PLAN-IT-B/BachelorProefCommunicatieEnEinde/README.md

# BachlorProef: Communicatie en einde.
Repository van Henri Vandeputte
