PLAN-IT-B/BachelorProefCommunicatieEnEinde/Algemene documentatie/Bestelling 11 april.docx

Bestelling 11 april - eindpuzzel

Minimum hoeveelheid | Wat | Link
1 | LCD display | (misschien heeft dramco er nog)
1 | 4x3 keypad | https://www.tinytronics.nl/shop/nl/schakelaars/manuele-schakelaars/keypads/keypad-3x4-matrix-membraan
1 | Blauwe (reset) knop | https://www.tinytronics.nl/shop/nl/schakelaars/manuele-schakelaars/drukknoppen-en-schakelaars/grote-blauwe-drukknop-24mm-of-40mm-reset
1 | Groene (start) knop | https://www.tinytronics.nl/shop/nl/schakelaars/manuele-schakelaars/drukknoppen-en-schakelaars/grote-groene-drukknop-24mm-of-40mm-reset
17 | 2 pin terminal block | https://www.tinytronics.nl/shop/nl/kabels-en-connectoren/connectoren/schroefterminals/2-pin-schroef-terminal-block-connector-5.08mm-afstand
3 | 3 pin terminal block | https://www.tinytronics.nl/shop/nl/kabels-en-connectoren/connectoren/schroefterminals/3-pin-schroef-terminal-block-connector-5.08mm-afstand
3 | Relais | https://www.tinytronics.nl/shop/nl/schakelaars/relais/relais-5v-250vac-10a
