PLAN-IT-B/BachelorProefCommunicatieEnEinde/Algemene documentatie/HenriVandeputte-GanttChart.pdf

22 | 27 | 6 | 13 | 20 | 27 | 3 | 10 | 17 | 24 | 1 | 8 | 15
Feb '22 | Mar '22 | Apr '22 | May '22
Planning_BachlorProef | 0h | 7%
Het begin | 0h | 67%
Persoonlijke opdracht gekregen | 0 | 100%
SWOT | 0 | 100%
Gantt chart | 0 | 100%
Implementatie | 0 | 100%
Blokschema persoonlijke opdracht | 0 | 0%
Eindpuzzel vastleggen | 0 | 100%
BOM indienen voor aankoop hardw... | 0 | 0%
Eerste deadline | 0 | 0%
Praktisch ontwerp | 0h | 0%
Datacommunicatie vastleggen | 0 | 0%
Integratie plan maken van alle puz... | 0 | 0%
Integratie van alle puzzels voorbere... | 0 | 0%
Werking puzzel via breadboardimpl... | 0 | 0%
Presentatie maken | 0 | 0%
Tweede deadline | 0 | 0%
PCB design maken | 0 | 0%
PCB ontwerp ter controle voorlegg... | 0 | 0%
PCB ontwerp bestellen | 0 | 0%
Testen van PCB | 0 | 0%
Test your buddy | 0 | 0%
Afgewerkte PCB | 0 | 0%
Technische documentatie op github | 0 | 0%
Deployment van alle puzzels en t... | 0h | 0%
Verslag test your buddy | 0 | 0%
De volledige escape room, klaarma... | 0 | 0%
Testing door eigen studenten | 0 | 0%
Eindverslag | 0 | 0%
Presentatie opdracht | 0 | 0%
Technische documentatie afwerken | 0 | 0%
Presentatie volledige escape room... | 0 | 0%

Het begin

Persoonlijke opdracht gekregen SWOT
Gantt chart
Implementatie
Blokschema persoonlijke opdracht Eindpuzzel vastleggen
BOM indienen voor aankoop hardware Eerste deadline

Praktisch ontwerp

Datacommunicatie vastleggen Integratie plan maken van alle puzzels Integratie van alle puzzels voorbereiden Werking puzzel via breadboardimplementatie Presentatie maken
Tweede deadline
PCB design maken
PCB ontwerp ter controle voorleggen voor finale bestelling PCB ontwerp bestellen
Testen van PCB
Test your buddy
Afgewerkte PCB
Technische documentatie op github

Deployment van alle puzzels en testing

Verslag test your buddy
De volledige escape room, klaarmaken voor gebruik Testing door eigen studenten Eindverslag
Presentatie opdracht
Technische documentatie afwerken
Presentatie volledige escape room + individuele opdracht

Powered by TCPDF (www.tcpdf.org)
