PLAN-IT-B/BachelorProefCommunicatieEnEinde/Algemene documentatie/Blokdiagramen cijfersloten.png

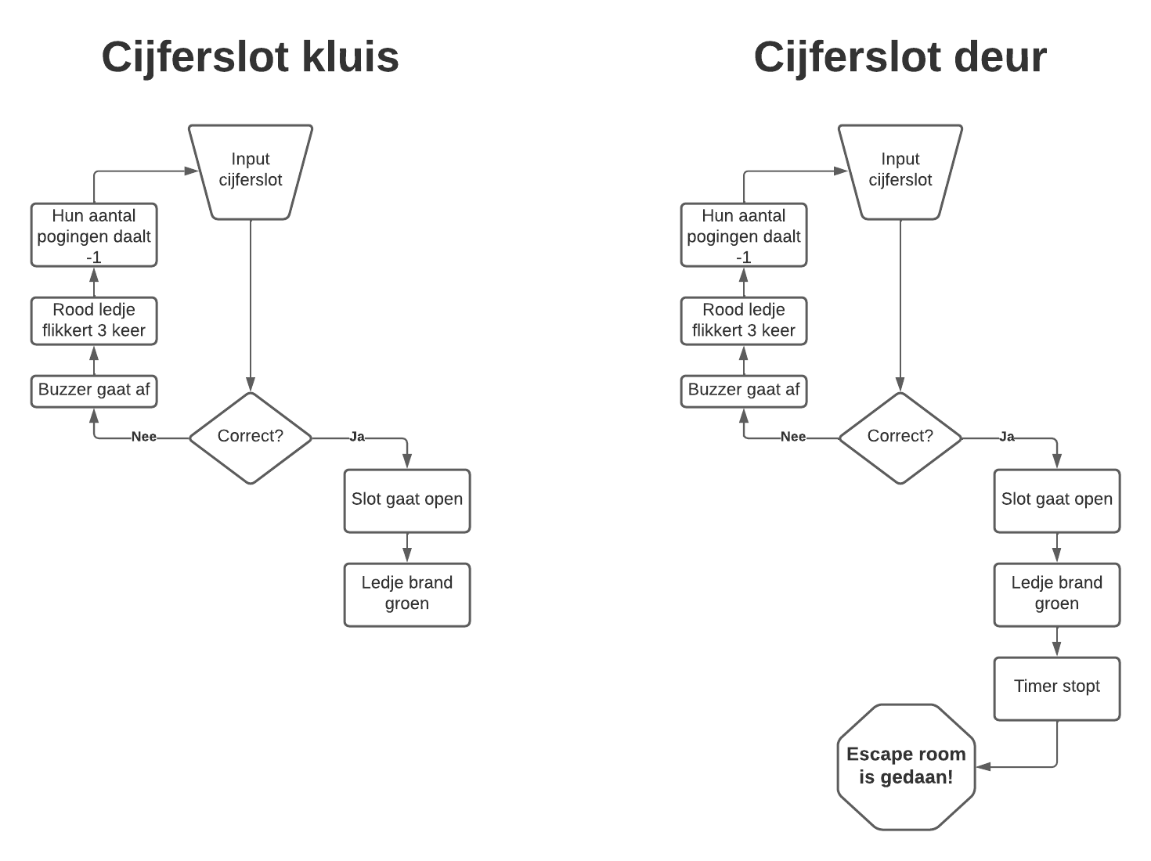
Algemene documentatie/Blokdiagramen cijfersloten.png
