PLAN-IT-B/BachelorProefCommunicatieEnEinde/Algemene documentatie/Flowchart reset-start werking.png

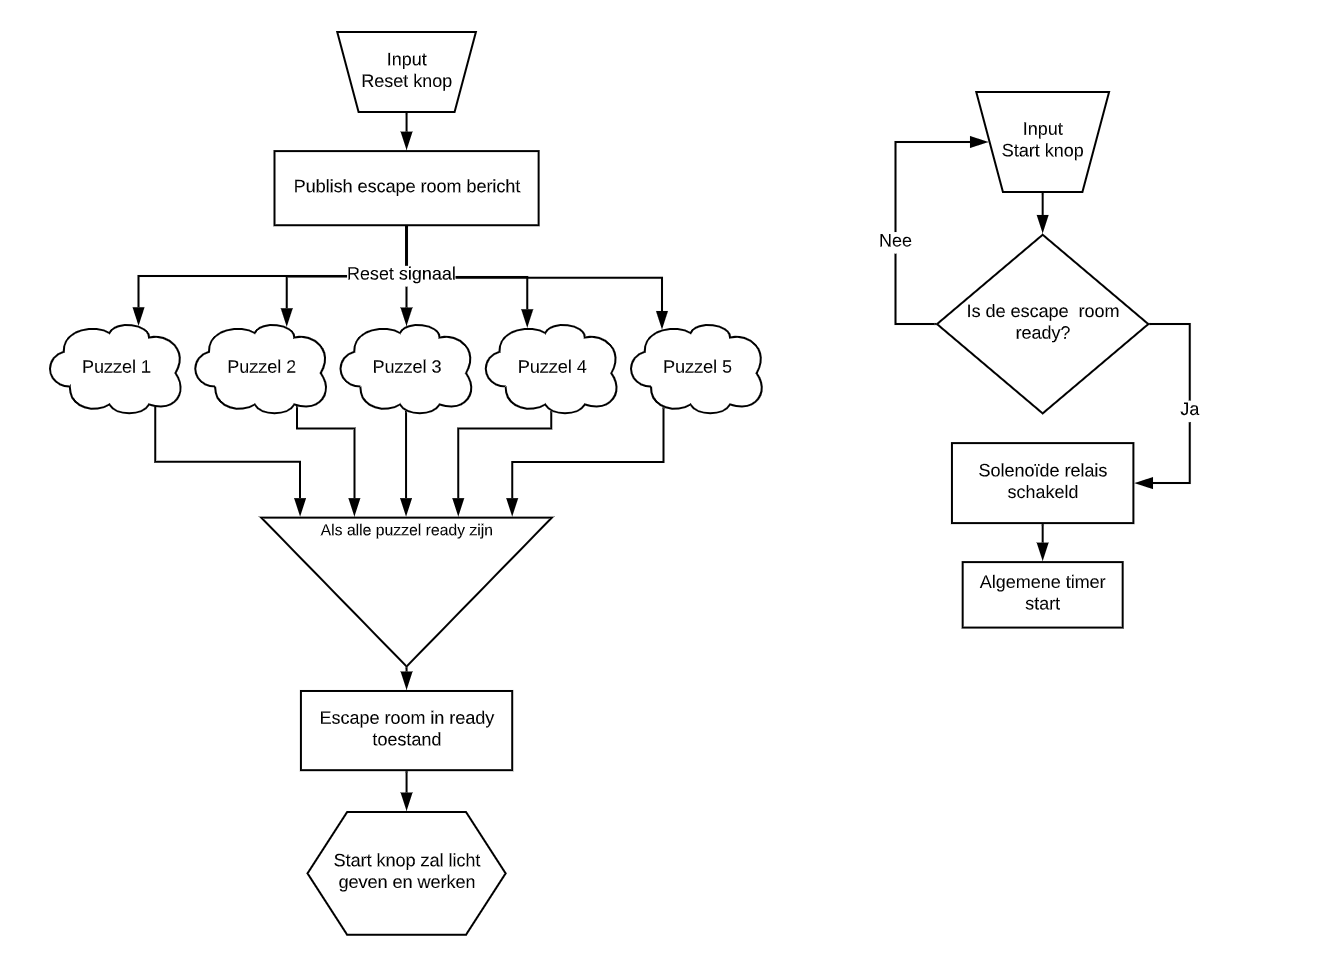
Algemene documentatie/Flowchart reset-start werking.png
