PLAN-IT-B/BachelorProefCommunicatieEnEinde/Documentatie eindpuzzel/Schakeling/pcb1-achterkant.png

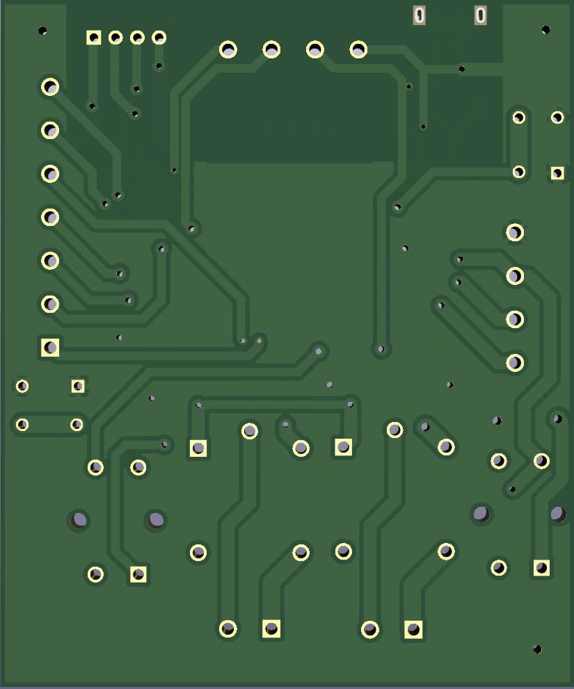
Documentatie eindpuzzel/Schakeling/pcb1-achterkant.png
