PLAN-IT-B/BachelorProefCommunicatieEnEinde/Documentatie eindpuzzel/Schakeling/pcb1-voorkant.png

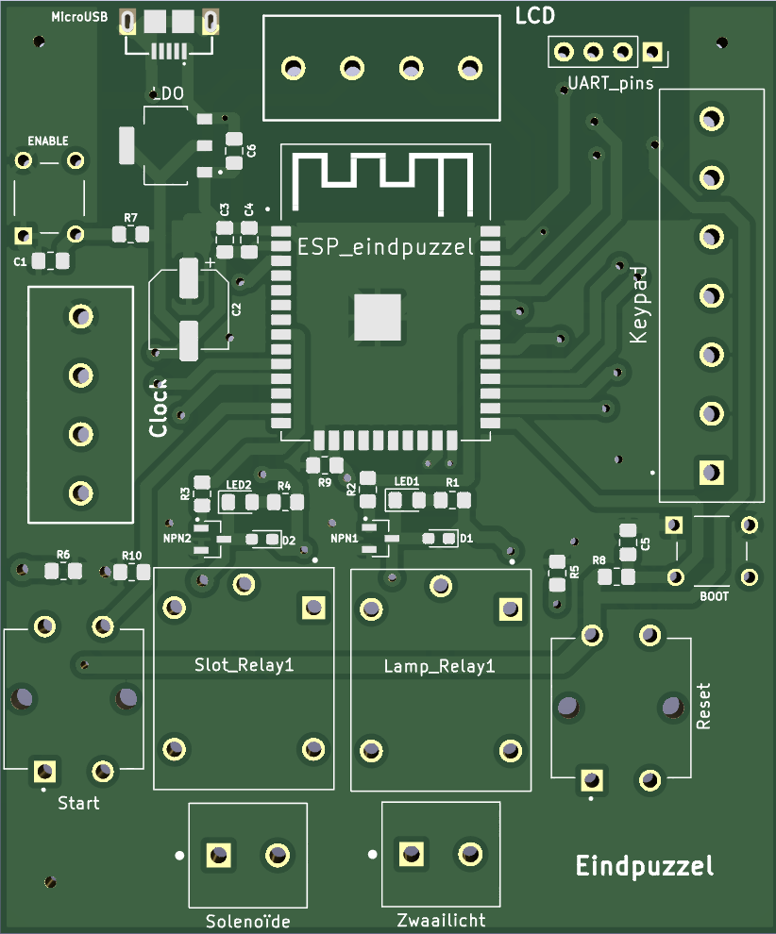
Documentatie eindpuzzel/Schakeling/pcb1-voorkant.png
