PLAN-IT-B/BachelorProefCommunicatieEnEinde/Documentatie UV-slot/Schakeling_UV-Lock/pcb2-achterkant.png

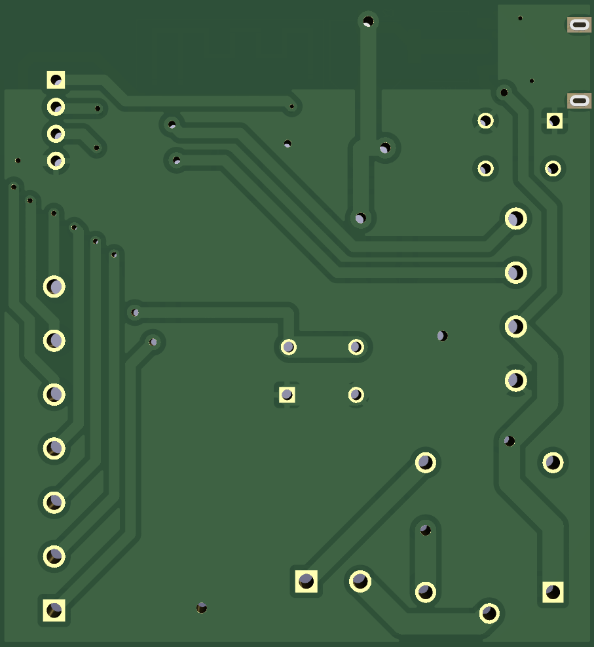
Documentatie UV-slot/Schakeling_UV-Lock/pcb2-achterkant.png
