PLAN-IT-B/BachelorProefCommunicatieEnEinde/Documentatie UV-slot/Schakeling_UV-Lock/pcb2-voorkant.png

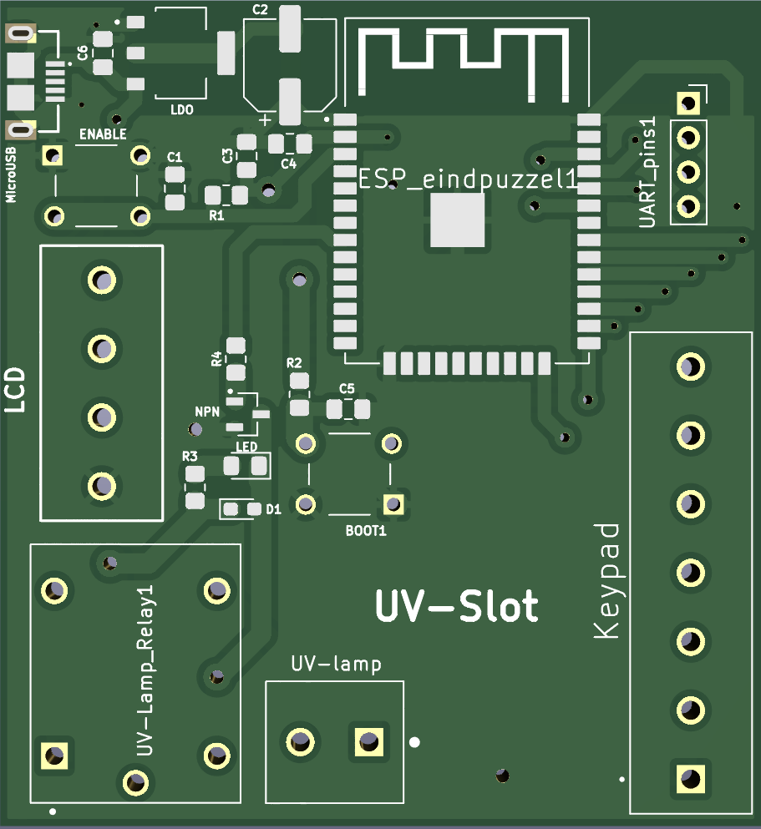
Documentatie UV-slot/Schakeling_UV-Lock/pcb2-voorkant.png
