PLAN-IT-B/BachelorProefCommunicatieEnEinde/Algemene documentatie/BOM Componenten.docx

Componenten lijst

Hoeveelheid | Wat | Waarvoor | Afbeelding | In bezit?

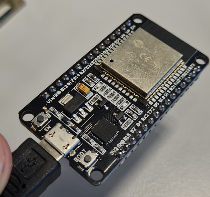
[picture p9: figure]
Geen beschrijving beschikbaar.

2 | Esp32 | 1 voor deurslot 1 voor kluisslot
1 | Raspberry | MQTT broker

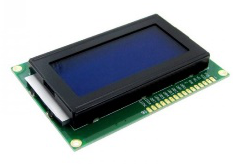
[picture p10: figure]
LCD Display 16*4 Karakters met Witte Tekst en Blauwe Backlight

2 | LCD display https://www.tinytronics.nl/shop/nl/displays/lcd/lcd-display-16*4-karakters-met-witte-tekst-en-blauwe-backlight | Feedback van hun ingetypte code weergeven | | 1 van de 2

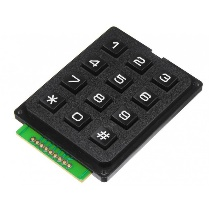
[picture p11: figure]
3x4 matrix keypad zwart

2 | 4x3keypads https://www.tinytronics.nl/shop/nl/schakelaars/manuele-schakelaars/keypads/keypad-3x4-matrix-membraan | Gemakkelijk om code in te typen | | 1 van de 2

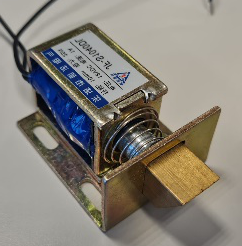
[picture p12: figure]
Geen beschrijving beschikbaar.

2 | Solenoïdes | Het vergrendelen van de kluis/deur

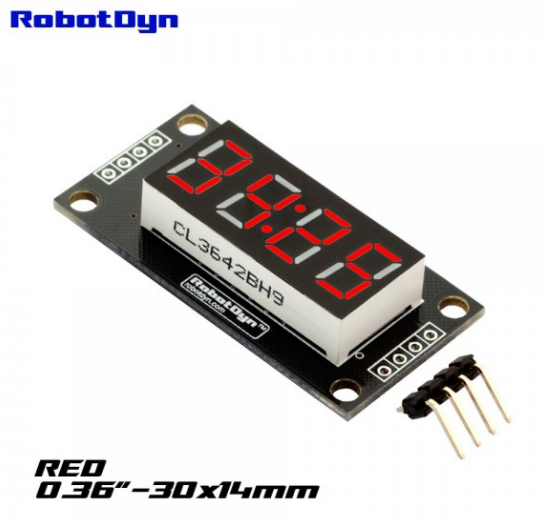
[picture p13: figure]

1 | 7 segment klok display https://www.tinytronics.nl/shop/nl/displays/segmenten/robotdyn-segmenten-display-module-4-karakters-klok-rood-tm1637-mini (Helaas wel zeer klein) | Tijdslimiet van de escape room bijhouden

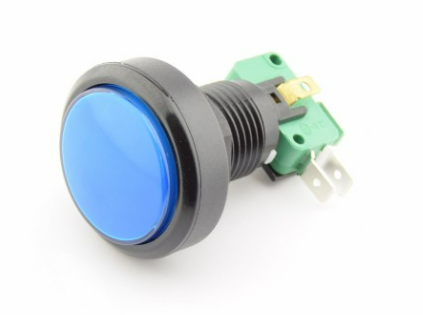
[picture p14: figure]

1 | Reset knop https://www.tinytronics.nl/shop/nl/schakelaars/manuele-schakelaars/drukknoppen-en-schakelaars/grote-blauwe-drukknop-24mm-of-40mm-reset | Zal reset knop zijn van gans de escape room (een reset signaal sturen naar alle puzzels). | | Nee

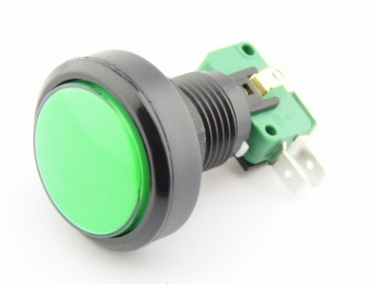
[picture p15: figure]

1 | Start knop https://www.tinytronics.nl/shop/nl/schakelaars/manuele-schakelaars/drukknoppen-en-schakelaars/grote-groene-drukknop-24mm-of-40mm-reset | Zal 30 seconden de solenoide intrekken. (Zodat mensen naar binnen kunnen) Na de 30 seconden zal de deur op slot en de timer starten. | | Nee
