PLAN-IT-B/BachelorProefCommunicatieEnEinde/Documentatie eindpuzzel/PuzzleBox2/Assem2.SLDASM

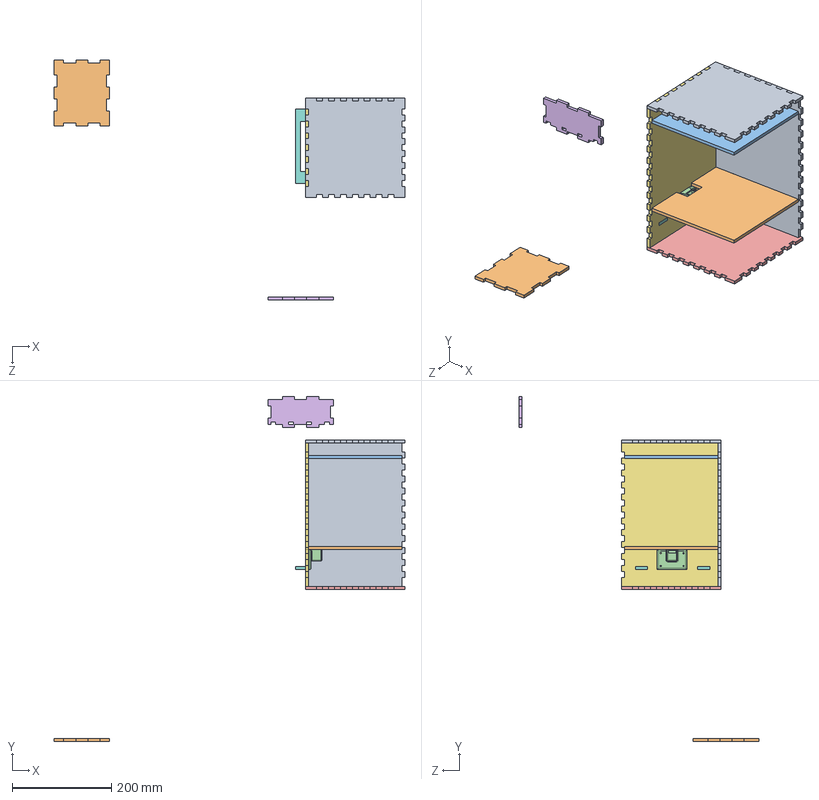
[picture p16: CAD file, 2022-05-20]
Documentatie eindpuzzel/PuzzleBox2/Assem2.SLDASM
706.0 x 694.0 x 482.0 mm
Back
Bottom
Handle
Left
Right
Top
LockFit
Tussenplaat1
Tussenplaat2
Front
