PLAN-IT-B/BachelorProefCommunicatieEnEinde/Documentatie UV-slot/UV-slot Box/Assembly_UV-slot.SLDASM

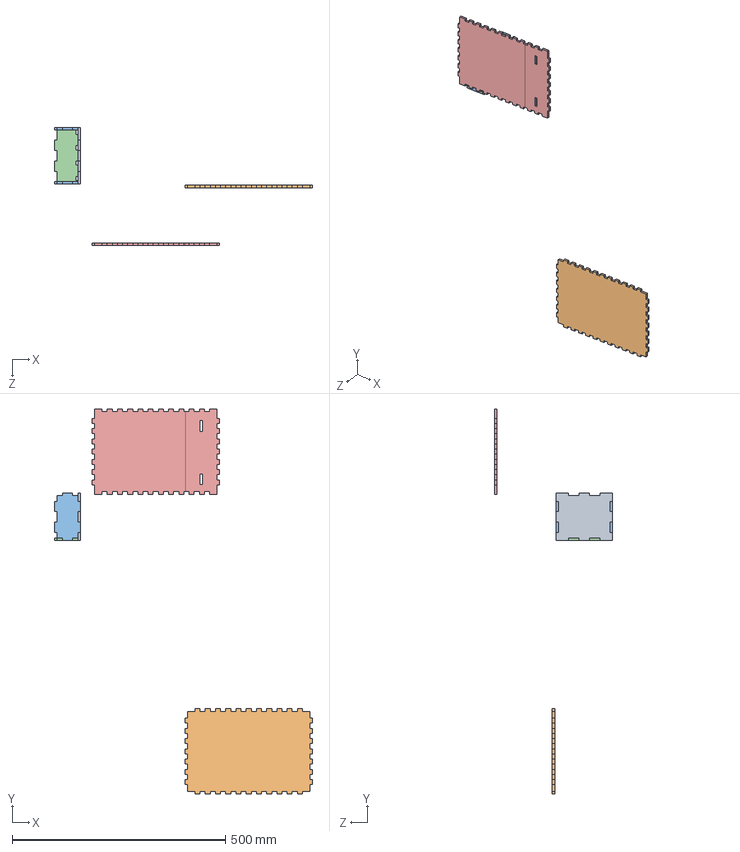
[picture p17: CAD file, 2022-05-20]
Documentatie UV-slot/UV-slot Box/Assembly_UV-slot.SLDASM
606.0 x 903.0 x 276.0 mm
Left
Right
Top&Bottom x 2
Front
Back
