PLAN-IT-B/BachelorProefCommunicatieEnEinde/Documentatie UV-slot/UV-slot Box/STL files/Assembly_UV-slot - Top&Bottom-2.STL

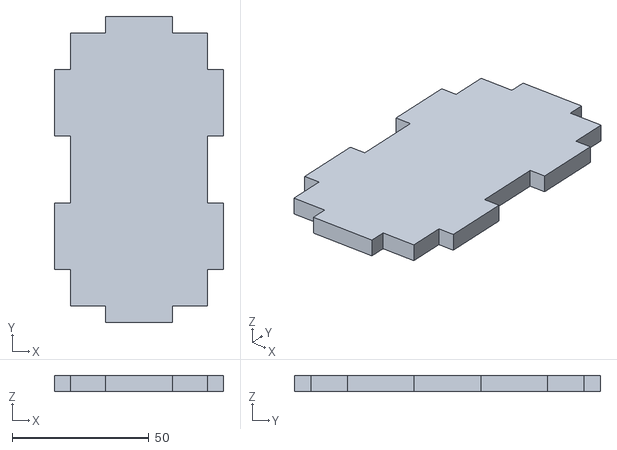
[picture p18: CAD file, 2022-05-22]
Documentatie UV-slot/UV-slot Box/STL files/Assembly_UV-slot - Top&Bottom-2.STL
62.0 x 112.0 x 6.00
