PLAN-IT-B/BachelorProefCommunicatieEnEinde/Documentatie UV-slot/UV-slot Box/STL files/Assembly_UV-slot - Left-1.STL

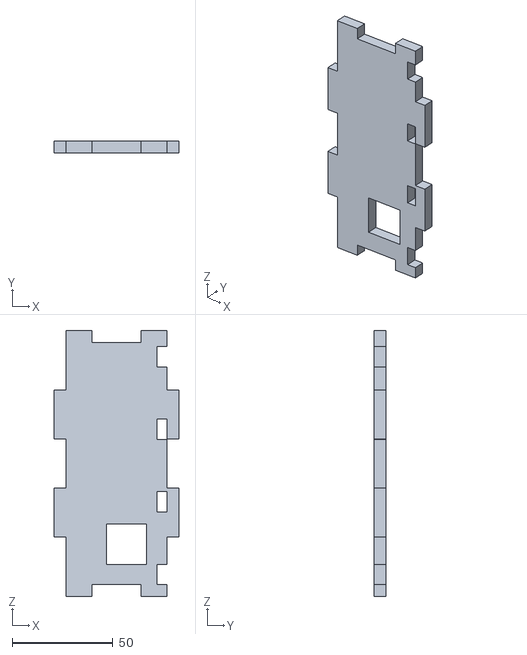
[picture p19: CAD file, 2022-05-22]
Documentatie UV-slot/UV-slot Box/STL files/Assembly_UV-slot - Left-1.STL
62.0 x 6.00 x 132.0
