PLAN-IT-B/BachelorProefCommunicatieEnEinde/Documentatie UV-slot/UV-slot Box/STL files/Assembly_UV-slot - Back-1.STL

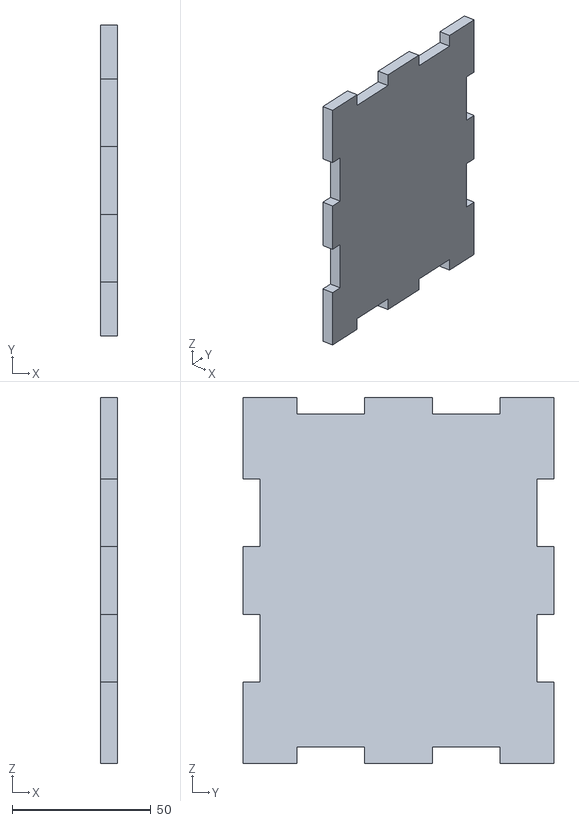
[picture p20: CAD file, 2022-05-22]
Documentatie UV-slot/UV-slot Box/STL files/Assembly_UV-slot - Back-1.STL
6.00 x 112.0 x 132.0
