PLAN-IT-B/BachelorProefCommunicatieEnEinde/Documentatie eindpuzzel/UV-puzzel/Puzzel.SLDPRT

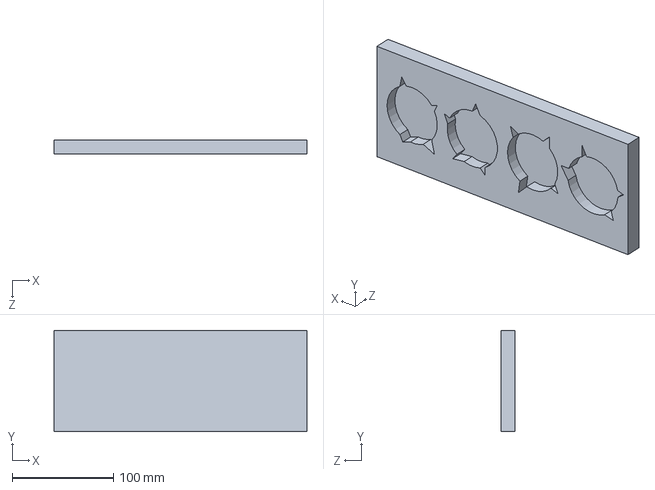
[picture p23: CAD file, 2022-05-21]
Documentatie eindpuzzel/UV-puzzel/Puzzel.SLDPRT
250.0 x 100.0 x 14.0 mm
