PLAN-IT-B/BachelorProefCommunicatieEnEinde/Documentatie eindpuzzel/PuzzleBox2/STL files Puzzlebox/Puzzlebox - Tussenplaat1-1.STL

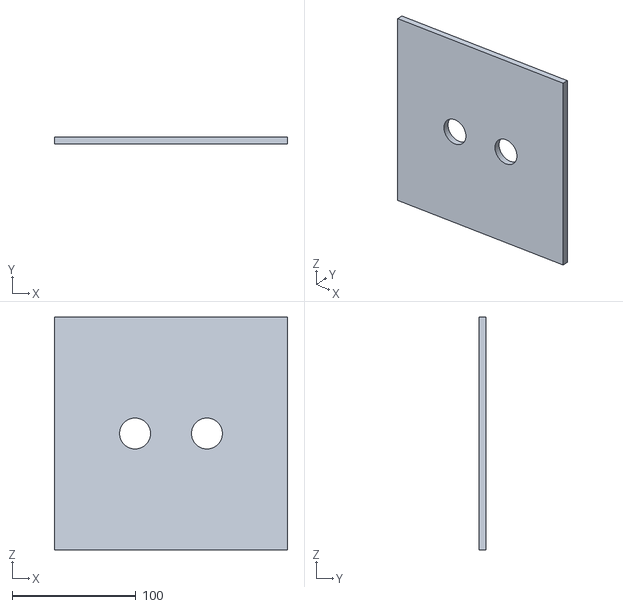
[picture p24: CAD file, 2022-05-22]
Documentatie eindpuzzel/PuzzleBox2/STL files Puzzlebox/Puzzlebox - Tussenplaat1-1.STL
188.0 x 6.00 x 188.0
