PLAN-IT-B/BachelorProefCommunicatieEnEinde/Documentatie eindpuzzel/UV-puzzel/PuzzleCut.DXF

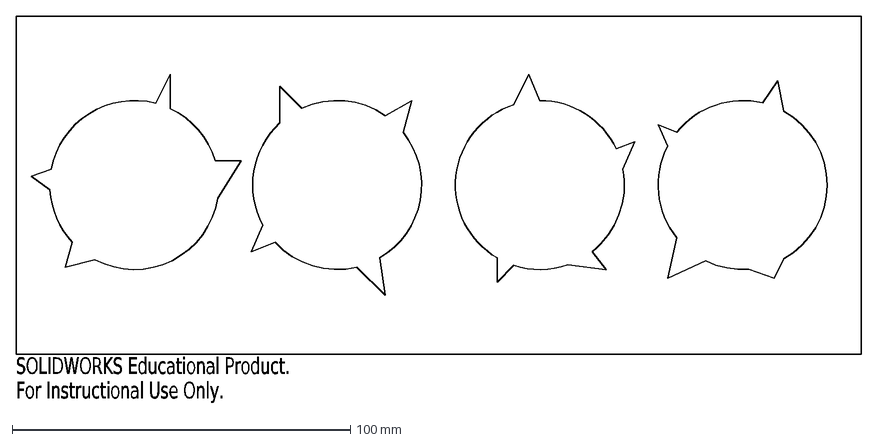
[picture p25: CAD file, 2022-05-17]
Documentatie eindpuzzel/UV-puzzel/PuzzleCut.DXF
SOLIDWORKS Educational Product.
For Instructional Use Only.
