PLAN-IT-B/BachelorProefCommunicatieEnEinde/Documentatie eindpuzzel/PuzzleBox2/STL files Puzzlebox/Puzzlebox - Bottom-1.STL

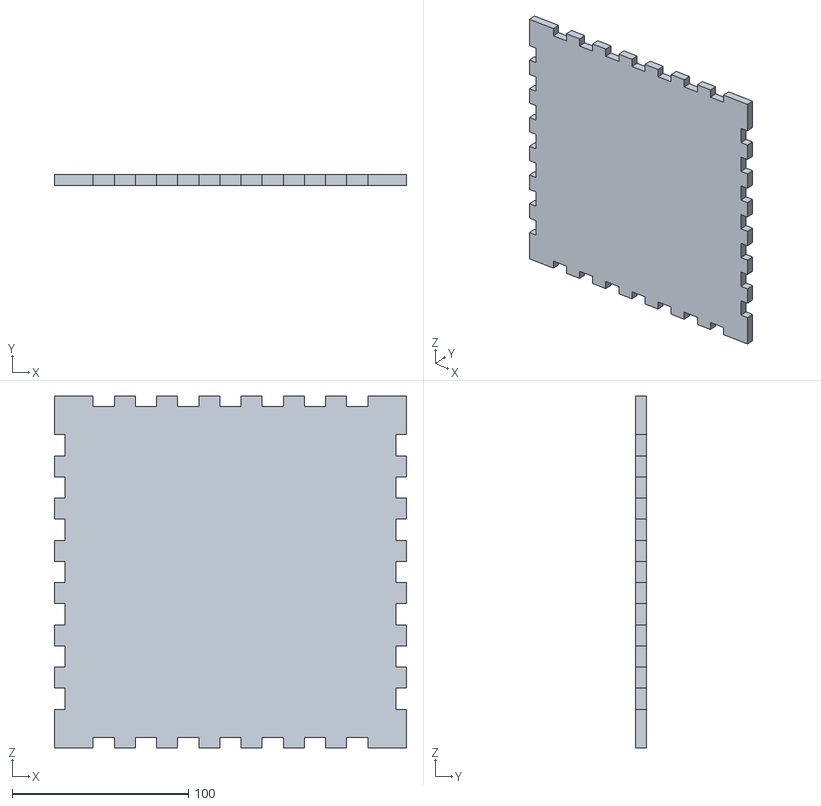
[picture p26: CAD file, 2022-05-22]
Documentatie eindpuzzel/PuzzleBox2/STL files Puzzlebox/Puzzlebox - Bottom-1.STL
200.0 x 6.00 x 200.0
