PLAN-IT-B/BachelorProefCommunicatieEnEinde/Documentatie eindpuzzel/PuzzleBox2/LockFit.SLDPRT

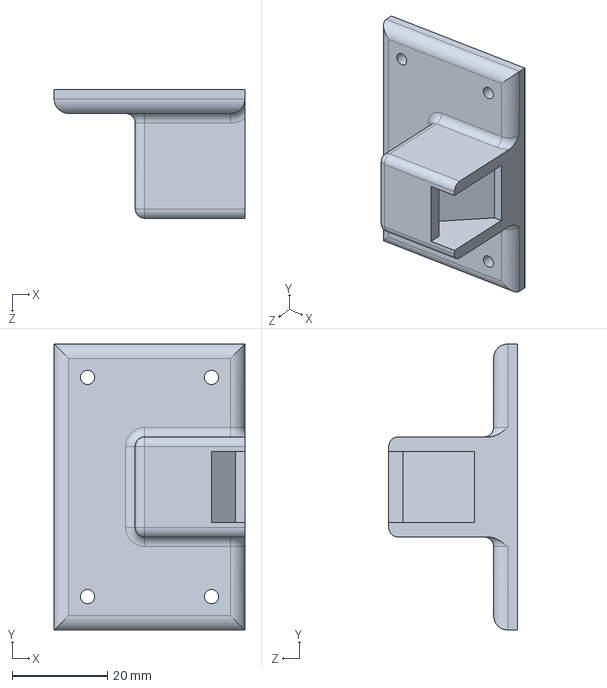
[picture p27: CAD file, 2022-05-14]
Documentatie eindpuzzel/PuzzleBox2/LockFit.SLDPRT
40.0 x 60.0 x 27.0 mm
