PLAN-IT-B/BachelorProefCommunicatieEnEinde/Documentatie eindpuzzel/PuzzleBox2/Tussenplaat2.SLDPRT

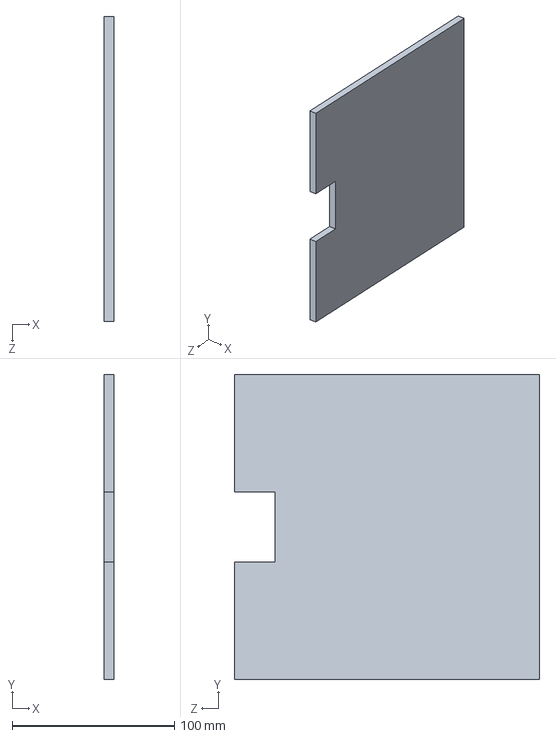
[picture p28: CAD file, 2022-05-09]
Documentatie eindpuzzel/PuzzleBox2/Tussenplaat2.SLDPRT
6.00 x 188.0 x 188.0 mm
