PLAN-IT-B/BachelorProefCommunicatieEnEinde/Documentatie eindpuzzel/PuzzleBox2/STL files Puzzlebox/Puzzlebox - Right-1.STL

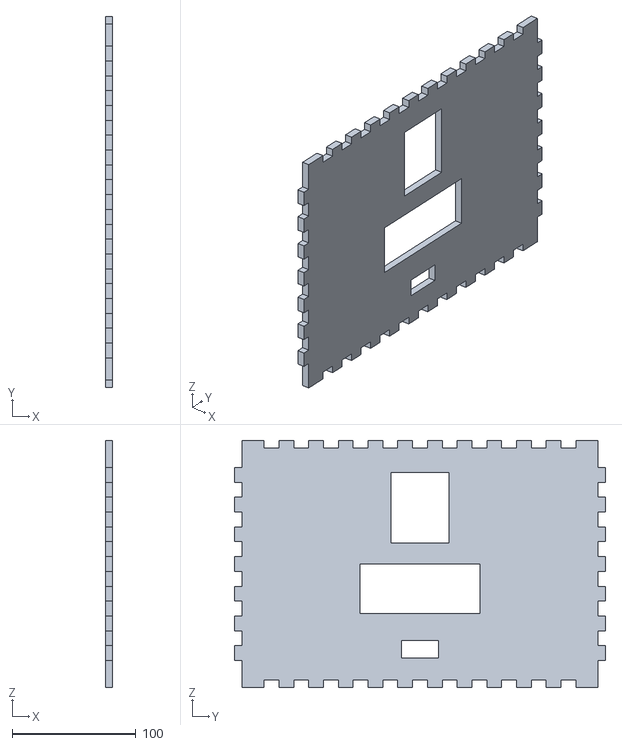
[picture p29: CAD file, 2022-05-22]
Documentatie eindpuzzel/PuzzleBox2/STL files Puzzlebox/Puzzlebox - Right-1.STL
6.00 x 300.0 x 200.0
