PLAN-IT-B/BachelorProefCommunicatieEnEinde/Documentatie eindpuzzel/PuzzleBox2/Handle.SLDPRT

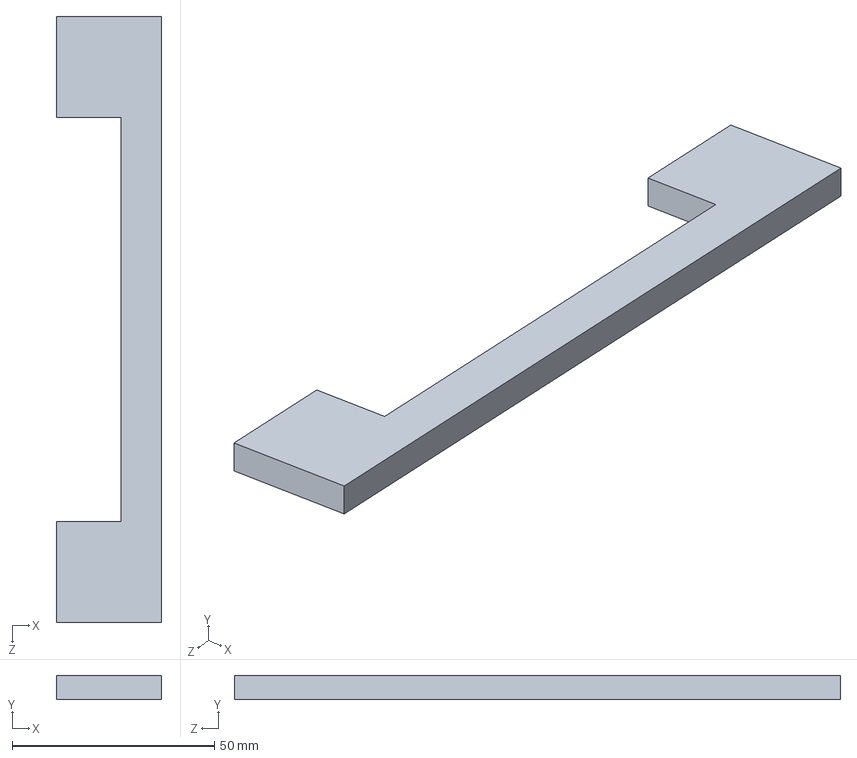
[picture p30: CAD file, 2022-05-06]
Documentatie eindpuzzel/PuzzleBox2/Handle.SLDPRT
26.0 x 6.00 x 150.0 mm
