PLAN-IT-B/BachelorProefCommunicatieEnEinde/Documentatie eindpuzzel/PuzzleBox2/box (3).dxf

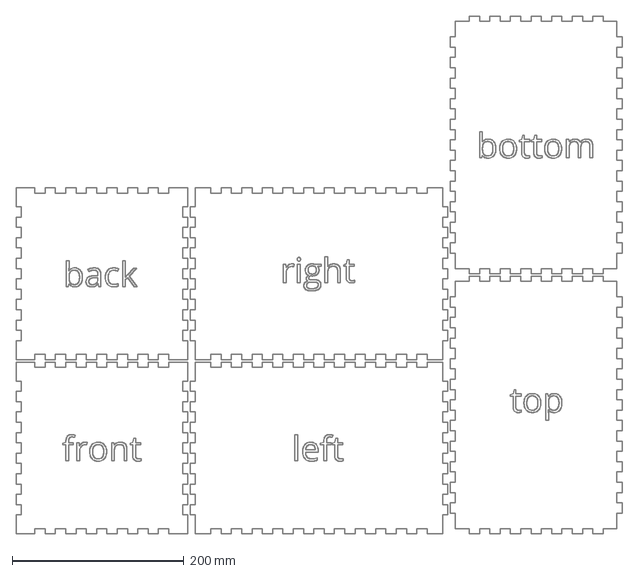
[picture p31: CAD file, 2022-05-06]
Documentatie eindpuzzel/PuzzleBox2/box (3).dxf
706.0 x 603.0 mm
