PLAN-IT-B/BachelorProefCommunicatieEnEinde/Documentatie eindpuzzel/PuzzleBox2/STL files Puzzlebox/LockFit.STL

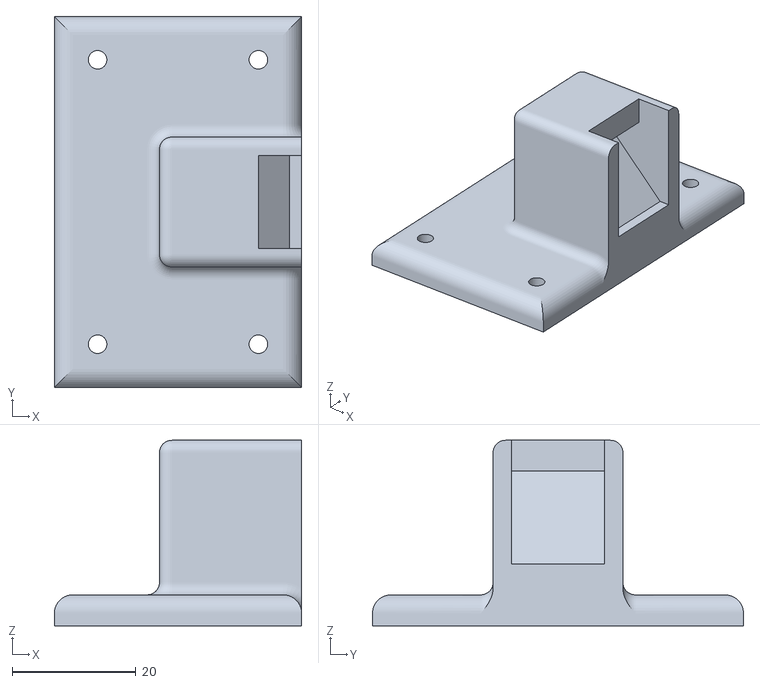
[picture p32: CAD file, 2022-05-14]
Documentatie eindpuzzel/PuzzleBox2/STL files Puzzlebox/LockFit.STL
40.0 x 60.0 x 30.0
