PLAN-IT-B/BachelorProefCommunicatieEnEinde/Documentatie eindpuzzel/PuzzleBox2/Left2.DXF

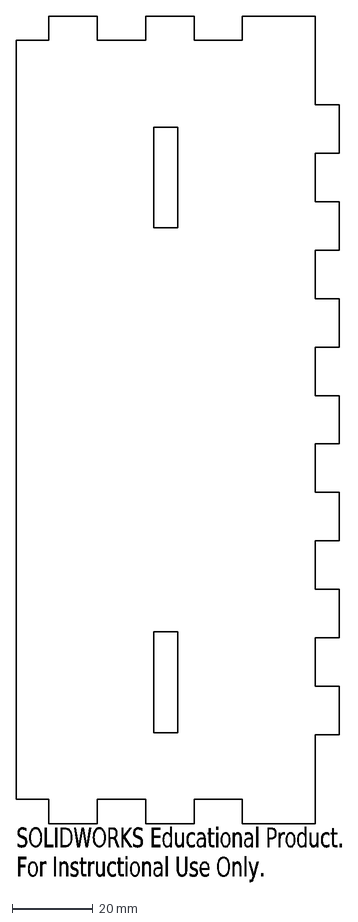
[picture p33: CAD file, 2022-05-06]
Documentatie eindpuzzel/PuzzleBox2/Left2.DXF
SOLIDWORKS Educational Product.
For Instructional Use Only.
