PLAN-IT-B/BachelorProefCommunicatieEnEinde/Documentatie eindpuzzel/PuzzleBox2/Left1.DXF

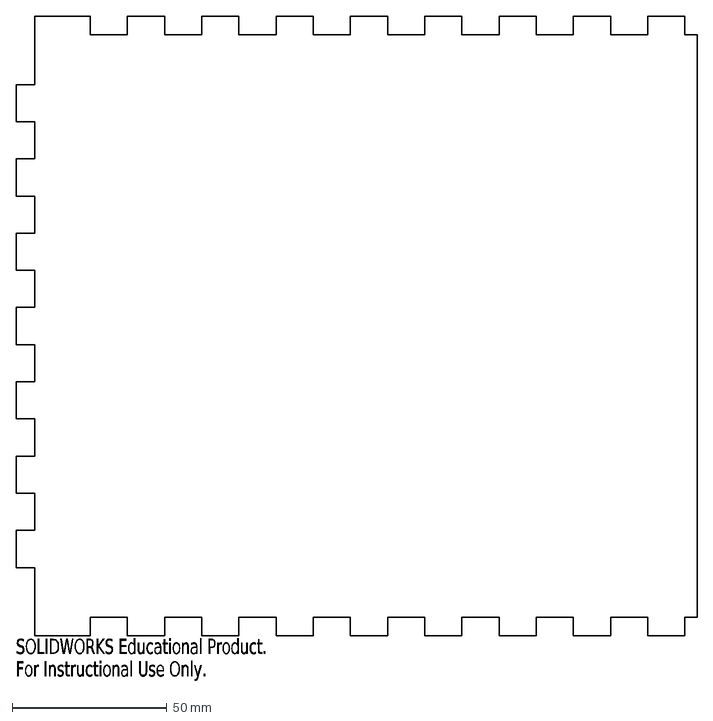
[picture p34: CAD file, 2022-05-06]
Documentatie eindpuzzel/PuzzleBox2/Left1.DXF
SOLIDWORKS Educational Product.
For Instructional Use Only.
