PLAN-IT-B/BachelorProefCommunicatieEnEinde/(list of files, cad)

Other CAD files:
Documentatie UV-slot/UV-slot Box/STL files/Assembly_UV-slot - Top&Bottom-1.STL
Documentatie UV-slot/UV-slot Box/STL files/Assembly_UV-slot - Right-1.STL
Documentatie eindpuzzel/PuzzleBox2/Front.SLDPRT
Documentatie UV-slot/UV-slot Box/Back.SLDPRT
Documentatie eindpuzzel/PuzzleBox2/Left.SLDPRT
Documentatie UV-slot/UV-slot Box/Front.SLDPRT
Documentatie eindpuzzel/PuzzleBox2/STL files Puzzlebox/Puzzlebox - LockFit-1.STL
Documentatie UV-slot/UV-slot Box/Right.SLDPRT
Documentatie eindpuzzel/PuzzleBox2/STL files Puzzlebox/Puzzlebox - Left-1.STL
Documentatie UV-slot/UV-slot Box/Left.SLDPRT
Documentatie eindpuzzel/PuzzleBox2/Tussenplaat1.SLDPRT
Documentatie UV-slot/UV-slot Box/Top&Bottom.SLDPRT
Documentatie eindpuzzel/PuzzleBox2/Back.SLDPRT
Documentatie eindpuzzel/PuzzleBox2/STL files Puzzlebox/Puzzlebox - Back-1.STL
Documentatie eindpuzzel/PuzzleBox2/STL files Puzzlebox/Puzzlebox - Tussenplaat2-1.STL
Documentatie eindpuzzel/PuzzleBox2/Top.SLDPRT
Documentatie eindpuzzel/PuzzleBox2/STL files Puzzlebox/Puzzlebox - Handle-1.STL
Documentatie eindpuzzel/PuzzleBox2/STL files Puzzlebox/Puzzlebox - Top-1.STL
Documentatie eindpuzzel/PuzzleBox2/Bottom.SLDPRT
Documentatie eindpuzzel/PuzzleBox2/Right.SLDPRT
Documentatie UV-slot/UV-slot Box/Back.DXF
Documentatie UV-slot/UV-slot Box/Front.DXF
Documentatie UV-slot/UV-slot Box/Left.DXF
Documentatie UV-slot/UV-slot Box/Right.DXF
Documentatie UV-slot/UV-slot Box/Top&Bottom.DXF
Documentatie eindpuzzel/PuzzleBox2/Back.DXF
Documentatie eindpuzzel/PuzzleBox2/Bottom.DXF
Documentatie eindpuzzel/PuzzleBox2/Front.DXF
Documentatie eindpuzzel/PuzzleBox2/Handle.DXF
Documentatie eindpuzzel/PuzzleBox2/Right.DXF
Documentatie eindpuzzel/PuzzleBox2/Top.DXF
Documentatie eindpuzzel/PuzzleBox2/Tussenplaat1.DXF
Documentatie eindpuzzel/PuzzleBox2/Tussenplaat2.DXF
Documentatie eindpuzzel/UV-puzzel/Puzzel.STL
