PLAN-IT-B/BachelorProefCommunicatieEnEinde/Documentatie eindpuzzel/Te printen documenten/Tip.docx

TIP:

De brochures en posters over de SDG’s zijn niet belangrijk voor het oplossen van de escaperoom.
