PLAN-IT-B/BachelorProefCommunicatieEnEinde/Documentatie eindpuzzel/Te printen documenten/Affiches_SDG.docx

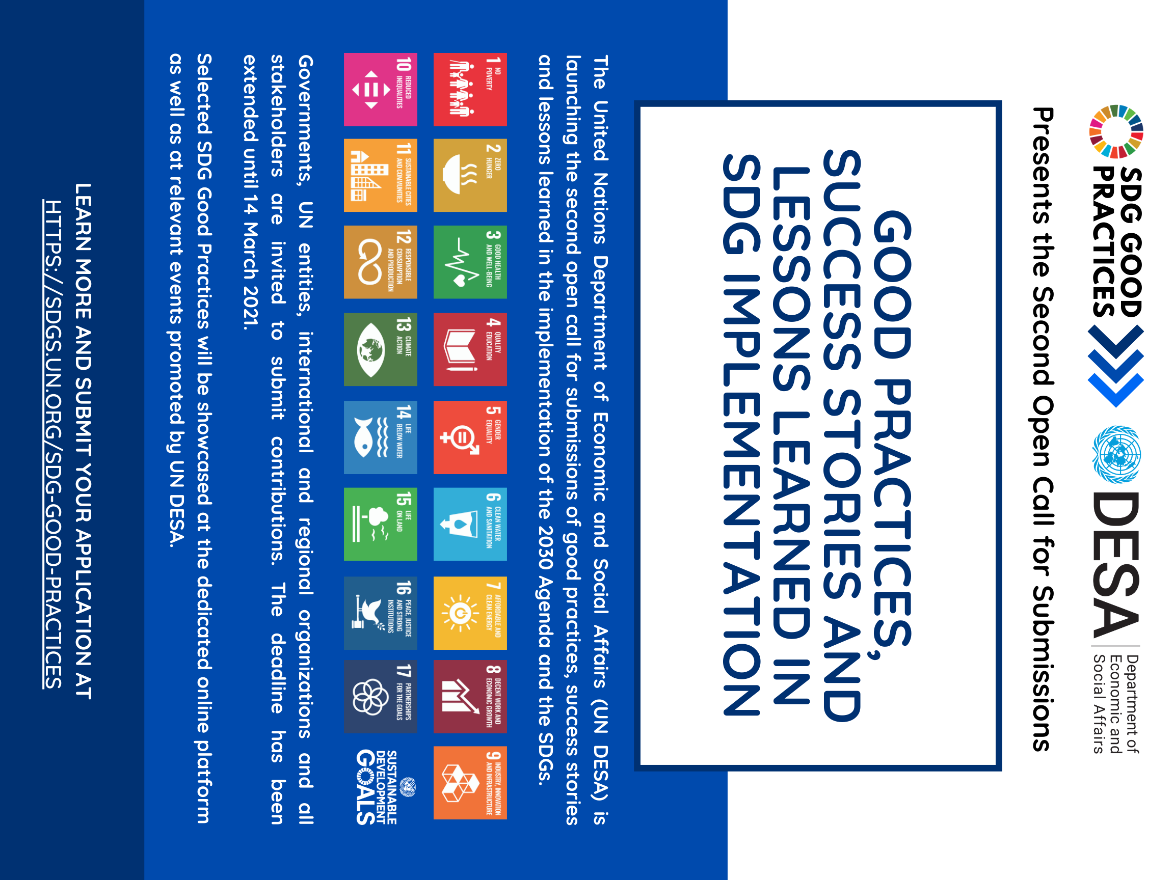
[picture p35: figure]
NOW OPEN! Second Open Call for SDG Good Practices | Global Future Cities Programme
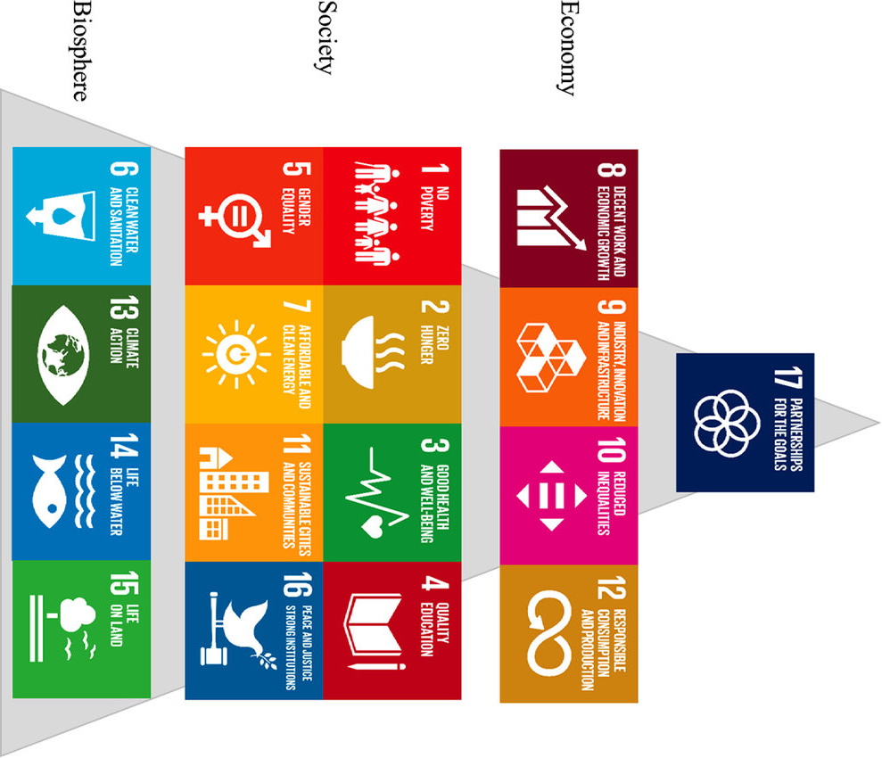
[picture p36: figure]
Interconnections between the SDG, adapted from Rockström and Sukhdev (2016) .
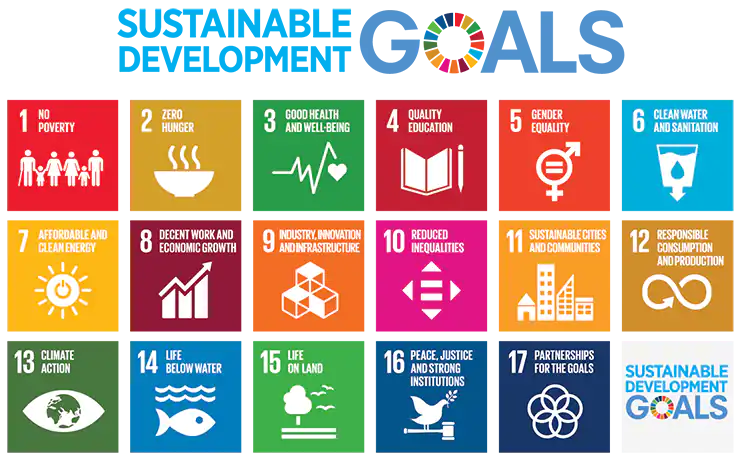
[picture p37: figure]
