PLAN-IT-B/BachelorProefCommunicatieEnEinde/Algemene documentatie/Kosten_Analyse.pdf

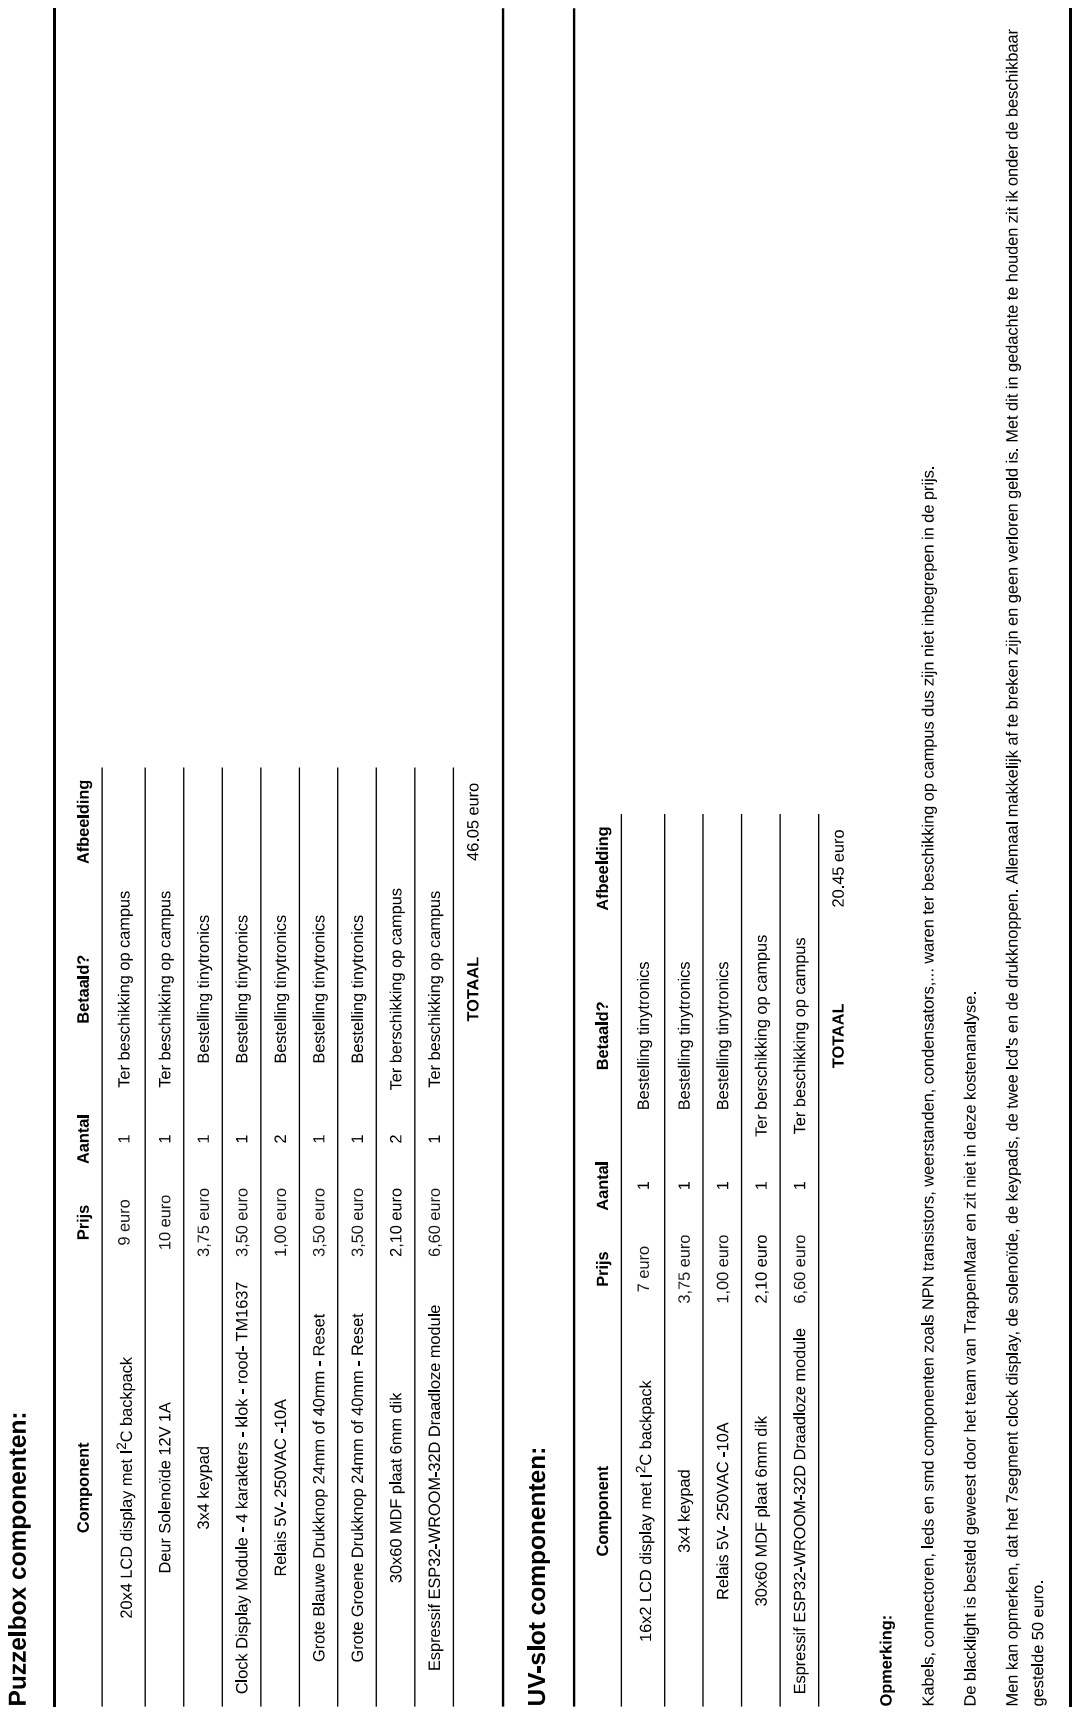
[picture p38: page 1]
