PLAN-IT-B/BachelorProefCommunicatieEnEinde/Documentatie UV-slot/Schakeling_UV-Lock/Schakeling_UV-Lock.kicad_pcb

## KiCad design Documentatie UV-slot/Schakeling_UV-Lock/Schakeling_UV-Lock.kicad_pcb (2022-04-26)

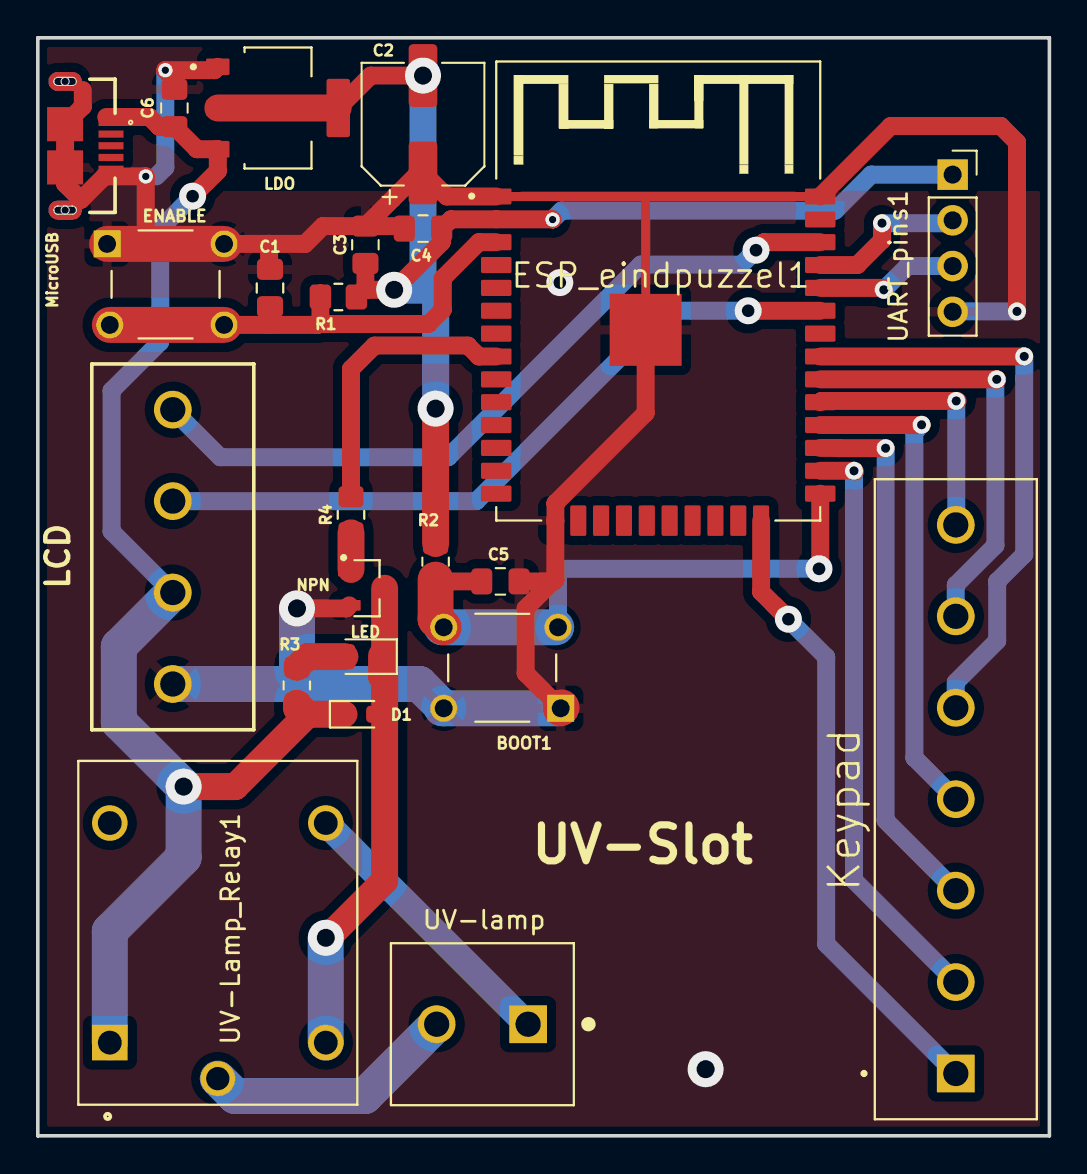
[picture p39: board Schakeling_UV-Lock.kicad_pcb from above]

Board: 2 copper layers, 56.2 x 61.0 mm, 23 parts (0 on the bottom side), 22 nets.

Parts:
BOOT1: SW_Push; TE_3-1825910-1
C1, C4, C5: 0.1u; C_0805_2012Metric_Pad1.18x1.45mm_HandSolder
C2: 220u; CP_Elec_6.3x7.7
C3: 22u; C_0805_2012Metric_Pad1.18x1.45mm_HandSolder
C6: 10u; C_0805_2012Metric_Pad1.18x1.45mm_HandSolder
D1: D; LED_0603_1608Metric_Pad1.05x0.95mm_HandSolder
ENABLE: SW_Push; TE_3-1825910-1
ESP_eindpuzzel1: ESP-WROOM-32; MODULE_ESP-WROOM-32
Keypad: 282841-7; TE_282841-7
LCD: 282841-4; 2828414
LDO: AMS1117; SOT229P700X180-4N
LED: LED; LED_0805_2012Metric_Pad1.15x1.40mm_HandSolder
MicroUSB: USB3090-XX-X_REVE; GCT_USB3090-XX-X_REVE
NPN: BC817; SOT95P230X110-3N
R1, R2: 10k; R_0805_2012Metric_Pad1.20x1.40mm_HandSolder
R3, R4: 1k; R_0805_2012Metric_Pad1.20x1.40mm_HandSolder
UART_pins1: Conn_01x04_Female; PinSocket_1x04_P2.54mm_Vertical
UV-Lamp_Relay1: SRD-05VDC-SL-C; RELAY_SRD-05VDC-SL-C
UV-lamp: 282841-2; TE_282841-2

Connections:
3.3V: C2.2, C3.2, C4.2, ESP_eindpuzzel1.2 (3V3), LDO.2 (VOUT), LDO.4 (VOUT), R1.2, R2.1, UART_pins1.1
5V: C6.1, D1.1 (K), LCD.2, LDO.3 (VIN), MicroUSB.1 (VBUS), R3.1, UV-Lamp_Relay1.A1
GND: BOOT1.1, BOOT1.2, C1.1, C2.1, C3.1, C4.1, C5.1, C6.2, ENABLE.1, ENABLE.2, ESP_eindpuzzel1.1 (GND), ESP_eindpuzzel1.1.1 (GND), ESP_eindpuzzel1.15 (GND), ESP_eindpuzzel1.38 (GND), LCD.1, LDO.1 (ADJ/GND), MicroUSB.5 (GND), MicroUSB.6 (SHIELD), MicroUSB.7 (SHIELD), MicroUSB.8 (SHIELD), MicroUSB.9 (SHIELD), NPN.2, UART_pins1.4
IO2: ESP_eindpuzzel1.24 (IO2), Keypad.1
IO4: ESP_eindpuzzel1.26 (IO4), Keypad.2
IO5: ESP_eindpuzzel1.29 (IO5), Keypad.7
IO16: ESP_eindpuzzel1.27 (IO16), Keypad.3
IO17: ESP_eindpuzzel1.28 (IO17), Keypad.4
IO18: ESP_eindpuzzel1.30 (IO18), Keypad.6
IO19: ESP_eindpuzzel1.31 (IO19), Keypad.5
IO21: ESP_eindpuzzel1.33 (IO21), LCD.3
IO22: ESP_eindpuzzel1.36 (IO22), LCD.4
IO32: ESP_eindpuzzel1.8 (IO32), R4.2
unnamed: C1.2, ENABLE.3, ENABLE.4, ESP_eindpuzzel1.3 (EN), R1.1
unnamed: D1.2 (A), LED.1 (K), NPN.3, UV-Lamp_Relay1.A2
unnamed: BOOT1.3, BOOT1.4, C5.2, ESP_eindpuzzel1.25 (IO0), R2.2
unnamed: NPN.1, R4.1
unnamed: LED.2 (A), R3.2
unnamed: UV-Lamp_Relay1.COM, UV-lamp.2
unnamed: UV-Lamp_Relay1.NO, UV-lamp.1
RX: ESP_eindpuzzel1.34 (RXD0), UART_pins1.3
TX: ESP_eindpuzzel1.35 (TXD0), UART_pins1.2
