PLAN-IT-B/BachelorProefCommunicatieEnEinde/Documentatie eindpuzzel/Schakeling/Schakeling.kicad_pcb

## KiCad design Documentatie eindpuzzel/Schakeling/Schakeling.kicad_pcb (2022-04-16)

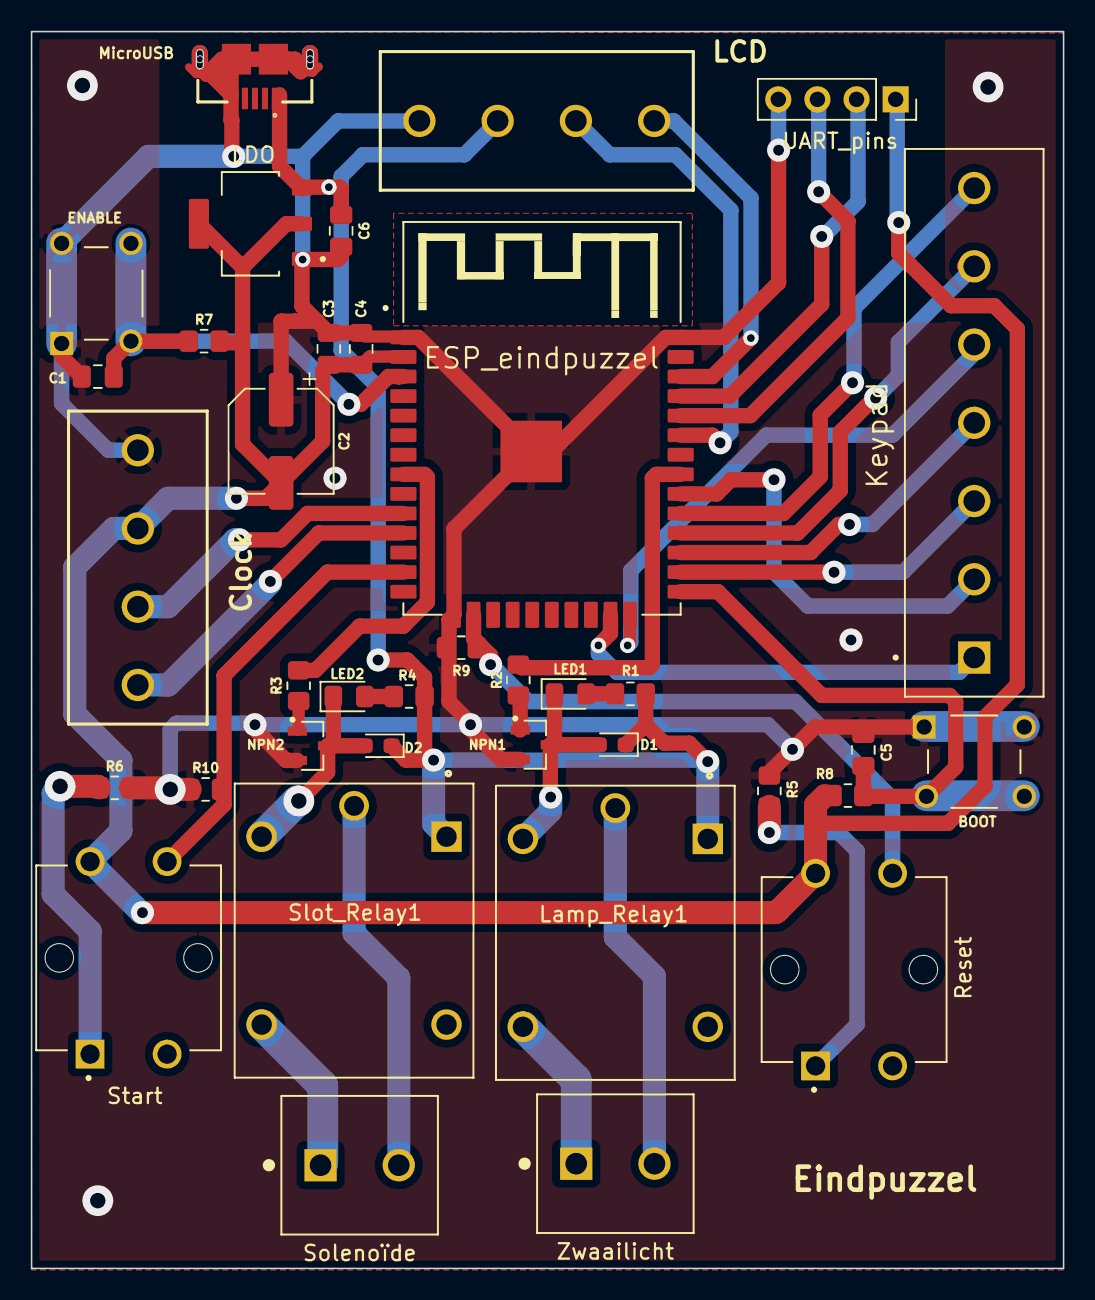
[picture p40: board Schakeling.kicad_pcb from above]

Board: 2 copper layers, 67.0 x 80.3 mm, 37 parts (0 on the bottom side), 34 nets.

Parts:
BOOT: SW_Push; TE_3-1825910-1
C1, C4, C5: 0.1u; C_0805_2012Metric_Pad1.18x1.45mm_HandSolder
C2: 220u; CP_Elec_6.3x7.7
C3: 22u; C_0805_2012Metric_Pad1.18x1.45mm_HandSolder
C6: 10u; C_0805_2012Metric_Pad1.18x1.45mm_HandSolder
Clock: 282841-4; 2828414
D1, D2: D; LED_0603_1608Metric_Pad1.05x0.95mm_HandSolder
ENABLE: SW_Push; TE_3-1825910-1
ESP_eindpuzzel: ESP-WROOM-32; MODULE_ESP-WROOM-32
Keypad: 282841-7; TE_282841-7
LCD: 282841-4; 2828414
LDO: AMS1117; SOT229P700X180-4N
LED1, LED2: LED; LED_0805_2012Metric_Pad1.15x1.40mm_HandSolder
Lamp_Relay1: SRD-05VDC-SL-C; RELAY_SRD-05VDC-SL-C
MicroUSB: USB3090-XX-X_REVE; GCT_USB3090-XX-X_REVE
NPN1, NPN2: BC817; SOT95P230X110-3N
R1, R2, R3, R4, R5, R6, R9, R10: 1k; R_0805_2012Metric_Pad1.20x1.40mm_HandSolder
R7, R8: 10k; R_0805_2012Metric_Pad1.20x1.40mm_HandSolder
Reset: B3F-4050; SW_B3F-4050
Slot_Relay1: SRD-05VDC-SL-C; RELAY_SRD-05VDC-SL-C
Solenoïde: 282841-2; TE_282841-2
Start: B3F-4050; SW_B3F-4050
UART_pins: Conn_01x04_Female; PinSocket_1x04_P2.54mm_Vertical
Zwaailicht: 282841-2; TE_282841-2

Connections:
3.3V: C2.2, C3.2, C4.2, Clock.3, ESP_eindpuzzel.2 (3V3), LDO.2 (VOUT), LDO.4 (VOUT), R7.2, R8.1, Reset.2, Start.2, UART_pins.1
5V: C6.1, D1.1 (K), D2.1 (K), LCD.2, LDO.3 (VIN), Lamp_Relay1.A1, MicroUSB.1 (VBUS), R1.1, R4.1, Slot_Relay1.A1
GND: BOOT.1, BOOT.2, C1.1, C2.1, C3.1, C4.1, C5.1, C6.2, Clock.4, ENABLE.1, ENABLE.2, ESP_eindpuzzel.1 (GND), ESP_eindpuzzel.1.1 (GND), ESP_eindpuzzel.15 (GND), ESP_eindpuzzel.38 (GND), LCD.1, LDO.1 (ADJ/GND), MicroUSB.5 (GND), MicroUSB.6 (SHIELD), MicroUSB.7 (SHIELD), MicroUSB.8 (SHIELD), MicroUSB.9 (SHIELD), NPN1.2, NPN2.2, R5.1, R6.1, R9.1, R10.1, UART_pins.4
IO2: ESP_eindpuzzel.24 (IO2), Keypad.5
IO4: ESP_eindpuzzel.26 (IO4), Keypad.3
IO5: ESP_eindpuzzel.29 (IO5), Keypad.7
IO13: ESP_eindpuzzel.16 (IO13), R9.2, Reset.4 (A)
IO14: ESP_eindpuzzel.13 (IO14), R10.2, Start.4 (A)
IO15: ESP_eindpuzzel.23 (IO15), Keypad.1
IO16: ESP_eindpuzzel.27 (IO16), Keypad.4
IO17: ESP_eindpuzzel.28 (IO17), Keypad.6
IO18: ESP_eindpuzzel.30 (IO18), Keypad.2
IO19: ESP_eindpuzzel.31 (IO19), R2.2
IO21: ESP_eindpuzzel.33 (IO21), LCD.3
IO22: ESP_eindpuzzel.36 (IO22), LCD.4
IO25: Clock.2, ESP_eindpuzzel.10 (IO25)
IO26: Clock.1, ESP_eindpuzzel.11 (IO26)
IO32: ESP_eindpuzzel.8 (IO32), R3.2
unnamed: C1.2, ENABLE.3, ENABLE.4, ESP_eindpuzzel.3 (EN), R7.1
unnamed: D1.2 (A), LED1.1 (K), Lamp_Relay1.A2, NPN1.3
unnamed: D2.2 (A), LED2.1 (K), NPN2.3, Slot_Relay1.A2
unnamed: BOOT.3, BOOT.4, C5.2, ESP_eindpuzzel.25 (IO0), R8.2
unnamed: LED1.2 (A), R1.2
unnamed: LED2.2 (A), R4.2
unnamed: Lamp_Relay1.COM, Zwaailicht.2
unnamed: Lamp_Relay1.NO, Zwaailicht.1
unnamed: NPN1.1, R2.1
unnamed: NPN2.1, R3.1
unnamed: R5.2, Reset.1
unnamed: R6.2, Start.1
unnamed: Slot_Relay1.COM, Solenoïde.2
unnamed: Slot_Relay1.NO, Solenoïde.1
RX: ESP_eindpuzzel.34 (RXD0), UART_pins.3
TX: ESP_eindpuzzel.35 (TXD0), UART_pins.2
