PLAN-IT-B/BachelorProefCommunicatieEnEinde/(commit log)

2022-03-08 Veel updates, adds en removes
    [Logboek.xlsx]
2022-03-15 Ganze dag werk
    [Logboek.xlsx]
2022-03-22 Veel betere code! + timer
2022-03-22 Kuisen van de repository, updaten van logboek en componenten lijst
    [Logboek.xlsx]
2022-03-29 Kicad en code updates
    [Schakeling.kicad_pcb, Schakeling.kicad_sch]
2022-04-07 PCB design files en veel meer
    [Schakeling.kicad_pcb, Schakeling_UV-Lock.kicad_pcb, Schakeling_UV-Lock.kicad_sch]
2022-04-07 Updates pcb eindpuzzel
    [Schakeling.kicad_pcb]
2022-04-13 Veel nieuwe aanpassing in de Kicad files ( en ook een paar in de code)
    [Schakeling.kicad_pcb, Schakeling.kicad_sch, Schakeling_UV-Lock.kicad_pcb, Schakeling_UV-Lock.kicad_sch]
2022-04-13 Wifi antennes extra ruimte gegeven
    [Schakeling.kicad_pcb, Schakeling_UV-Lock.kicad_pcb]
2022-04-16 Finale design PCB's
    [Schakeling.kicad_pcb, Schakeling.kicad_sch, Schakeling_UV-Lock.kicad_pcb, Schakeling_UV-Lock.kicad_sch]
2022-04-26 Updates en afwerking UV-slot code
2022-04-26 Updates in UV-slot code
2022-04-26 Solidworks bestanden UV-slot toegevoegd
    [Assembly_UV-slot.SLDASM, Back.SLDPRT, Front.SLDPRT, Left.SLDPRT, Right.SLDPRT, Schakeling_UV-Lock.kicad_pcb, Top&Bottom.SLDPRT]
2022-05-02 LaserCut bestanden, UV-slot code en Datacommunicatie update
    [Assembly_UV-slot.SLDASM, Back.DXF, Front.DXF, Left.DXF, Right.DXF, Top&Bottom.DXF]
2022-05-02 Updatec UV-slot code
2022-05-03 Eindpuzzel code, UV slot code
2022-05-06 Solidworks puzzelBox(en) :/
    [Assem1.SLDASM, Assem2.SLDASM, Back.DXF, Back.SLDPRT, Bottom.DXF, Bottom.SLDPRT, Front.DXF, Front.SLDPRT]
2022-05-17 Structuur en bug fixes
    [main.cpp]
2022-05-18 UV-slot samenwerking met buffer
2022-05-18 schematic geplot van eindpuzzel pcb
2022-05-18 Info schematic geupdate en svg files geplot
    [Schakeling.kicad_sch, Schakeling_UV-Lock.kicad_sch]
2022-05-18 3D-view pcb's toegevoegd
    [Schakeling.kicad_sch]
2022-05-19 bug fixes beide codes
    [main.cpp]
2022-05-19 Werkende versie van UV-slot in communicatie met buffer
2022-05-19 Bug fixes en EINDCODE
    [main.cpp]
2022-05-19 UV-slot code opgekuisd en klaar voor verslag.
2022-05-19 Super cleane code voor zowel UV-slot als eindpuzzel
2022-05-20 Betere structuur
    [Assem1.SLDASM, Assem2.SLDASM, Assembly_UV-slot.SLDASM, Back.DXF, Back.SLDPRT, Bottom.DXF, Bottom.SLDPRT, Front.DXF]
2022-05-21 Naam veranderd van basic mqqt connection
    [Puzzel.SLDPRT]
2022-05-21 Mooiere flowcharts en oude flowcharts weg
    [Logboek.xlsx]
2022-05-22 STL files toegevoegd
    [Assembly_UV-slot - Back-1.STL, Assembly_UV-slot - Front-1.STL, Assembly_UV-slot - Left-1.STL, Assembly_UV-slot - Right-1.STL, Assembly_UV-slot - Top&Bottom-1.STL, Assembly_UV-slot - Top&Bottom-2.STL, LockFit.STL, Puzzel.STL]
2022-05-23 betere reset start flowchart
